A-Ritvik/Mission-Board/CAD/Case Parts(V2).step

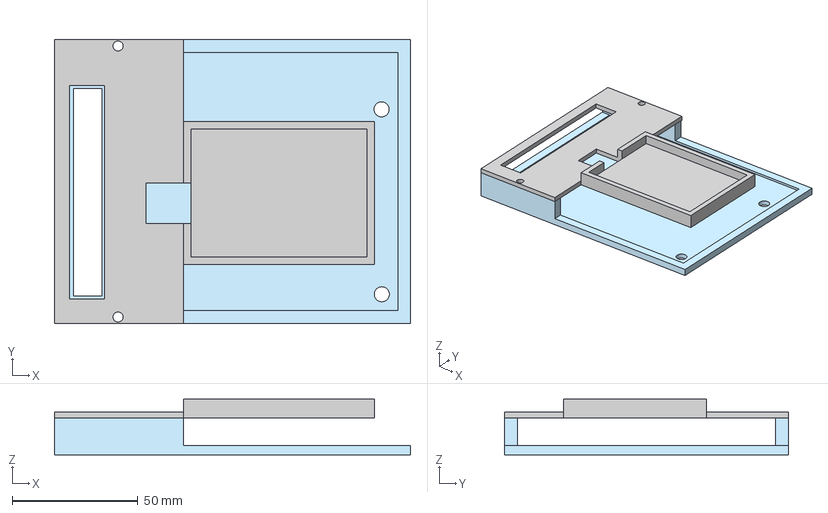
[picture p1: CAD file, 2026-08-01]
CAD/Case Parts(V2).step
141.7 x 112.9 x 22.2 mm
