A-Ritvik/Mission-Board/Production Files/Case Parts(V2) - Case-bottom.step

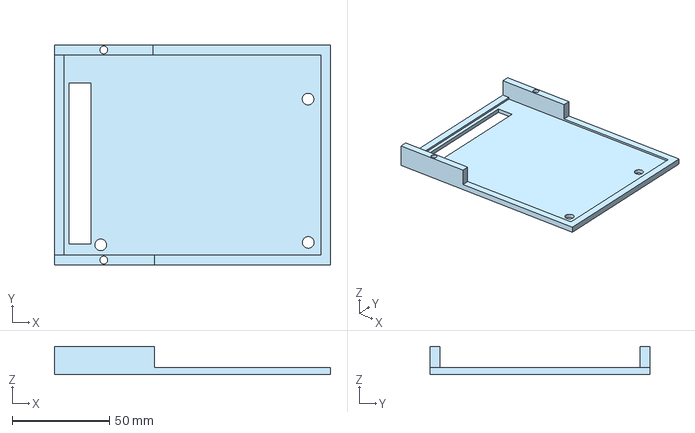
[picture p2: CAD file, 2026-08-01]
Production Files/Case Parts(V2) - Case-bottom.step
141.7 x 112.9 x 14.6 mm
