A-Ritvik/Mission-Board/Production Files/Case Parts(V2) - Case-top.step

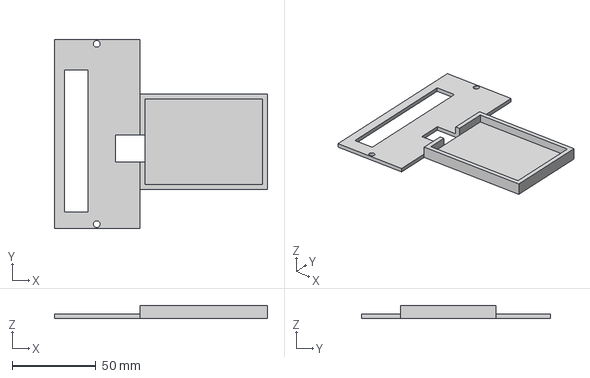
[picture p3: CAD file, 2026-08-01]
Production Files/Case Parts(V2) - Case-top.step
127.5 x 112.9 x 7.62 mm
