A-Ritvik/Mission-Board/PCB Design/missionBoard.kicad_pcb

## KiCad design PCB Design/missionBoard.kicad_pcb (2026-08-01)

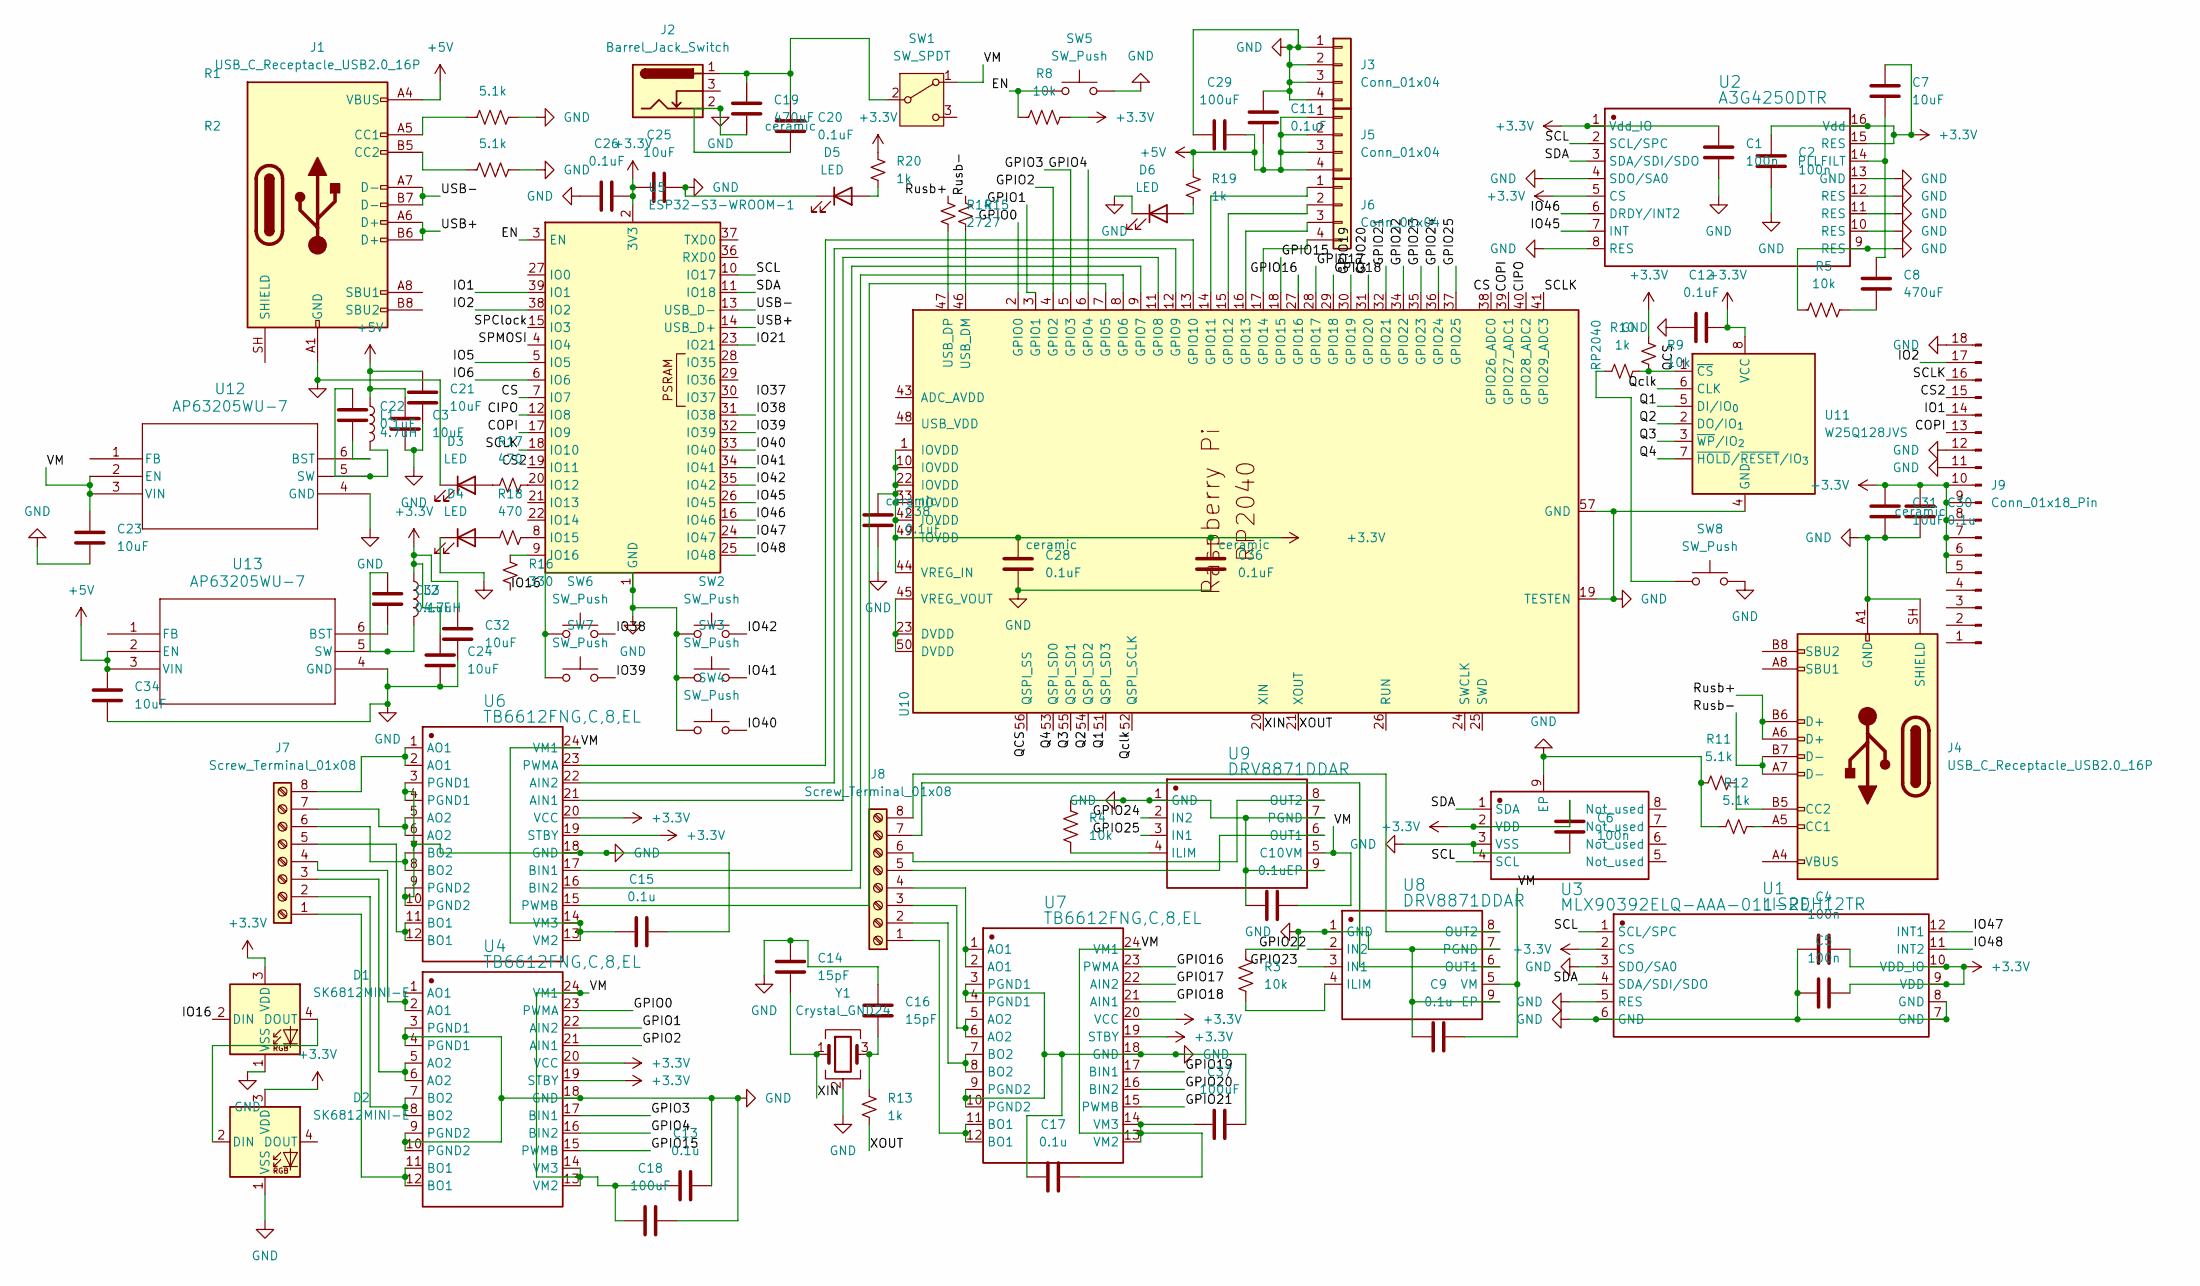
[picture p4: schematic missionBoard.kicad_sch]

Parts:
C1, C2, C4, C5, C6: 100n; C_0402_1005Metric
C3, C7, C21, C23, C24, C25, C31, C32, C34: 10uF; C_0402_1005Metric
C8, C19: 470uF; C_Elec_10x10.2
C9, C10, C13, C15, C17, C30: 0.1u; C_0402_1005Metric
C11, C12, C20, C22, C26, C28, C33, C36, C38: 0.1uF; C_0402_1005Metric
C14, C16: 15pF; C_0603_1608Metric
C18, C29, C37: 100uF; C_Elec_6.3x7.7
D1, D2: SK6812MINI-E; LED_SK6812MINI-E_3.2x2.8mm_P1.5mm_ReverseMount
D3, D4, D5, D6: LED; LED_0603_1608Metric
J1, J4: USB_C_Receptacle_USB2.0_16P; USB_C_Receptacle_HCTL_HC-TYPE-C-16P-01A
J2: Barrel_Jack_Switch; BarrelJack_Kycon_KLDX-0202-xC_Horizontal
J3, J5, J6: Conn_01x04; PinHeader_1x04_P2.54mm_Vertical
J7, J8: Screw_Terminal_01x08; TerminalBlock_Phoenix_MKDS-3-8-5.08_1x08_P5.08mm_Horizontal
J9: Conn_01x18_Pin; Hirose_FH12-18S-0.5SH_1x18-1MP_P0.50mm_Horizontal
L1, L2: 4.7uH; L_APV_ANR4030
R1, R2, R11, R12: 5.1k; R_0402_1005Metric
R3, R4, R5, R8, R9: 10k; R_0402_1005Metric
R10, R13: 1k; R_0402_1005Metric
R14, R15: 27; R_0402_1005Metric
R16: 330; R_0603_1608Metric
R17, R18: 470; R_0603_1608Metric
R19, R20: 1k; R_0603_1608Metric
SW1: SW_SPDT; SW_SPDT_Shouhan_MSK12C02
SW2, SW3, SW4, SW6, SW7: SW_Push; SW_SPST_SKQG_WithoutStem
SW5, SW8: SW_Push; SW_Push_SPST_NO_Alps_SKRK
U1: LIS2DH12TR; SENSOR_LIS2DH12; Manufacturer Part LIS2DH12TR
U2: A3G4250DTR; Manufacturer Part A3G4250DTR
U3: MLX90392ELQ-AAA-011-RE; UTDFN-8 2x2.5_MEL; Manufacturer Part MLX90392ELQ-AAA-011-RE
U4, U6, U7: TB6612FNG,C,8,EL; SOP65P760X160-24N; Manufacturer Part TB6612FNG,C,8,EL
U5: ESP32-S3-WROOM-1
U8, U9: DRV8871DDAR; VREG_LM5017MR_NOPB; Manufacturer Part DRV8871DDAR
U10: RP2040; RP2040-QFN-56
U11: W25Q128JVS; SOIC-8_5.3x5.3mm_P1.27mm
U12, U13: AP63205WU-7; SOIC_05WU-7_DIO
Y1: Crystal_GND24; Crystal_SMD_3225-4Pin_3.2x2.5mm

Connections:
+3.3V: C1.1, C2.1, C4.2, C5.2, C6.1, C7.1, C12.1, C24.1, C25.1, C26.2, C28.2, C30.1, C31.2, C32.1, C36.2, C38.2, D1.3 (VDD), D2.3 (VDD), J9.5, J9.6, J9.7, J9.8, J9.9, J9.10, L2.1, R8.2, R9.1, R20.1, U1.2 (CS), U1.9 (VDD), U1.10 (VDD_IO), U2.1 (Vdd_IO), U2.5 (CS), U2.15 (RES), U2.16 (Vdd), U3.2 (VDD), U4.19 (STBY), U4.20 (VCC), U5.2 (3V3), U6.19 (STBY), U6.20 (VCC), U7.19 (STBY), U7.20 (VCC), U10.1 (IOVDD), U10.10 (IOVDD), U10.22 (IOVDD), U10.33 (IOVDD), U10.42 (IOVDD), U10.44 (VREG_IN), U10.49 (IOVDD), U11.8 (VCC)
+5V: C3.1, C11.2, C21.1, C29.1, C34.1, J1.A4 (VBUS), J1.A9 (VBUS), J1.B4 (VBUS), J1.B9 (VBUS), J5.1, J5.2, J5.3, J5.4, L1.1, R19.1, U13.2 (EN), U13.3 (VIN)
/CIPO: U5.12 (IO8), U10.40 (GPIO28_ADC2)
/COPI: J9.13, U5.17 (IO9), U10.39 (GPIO27_ADC1)
/CS: U5.7 (IO7), U10.38 (GPIO26_ADC0)
/CS2: J9.15, U5.19 (IO11)
/EN: R8.1, SW5.1, U5.3 (EN)
/GPIO0: U4.23 (PWMA), U10.2 (GPIO0)
/GPIO1: U4.22 (AIN2), U10.3 (GPIO1)
/GPIO2: U4.21 (AIN1), U10.4 (GPIO2)
/GPIO3: U4.17 (BIN1), U10.5 (GPIO3)
/GPIO4: U4.16 (BIN2), U10.6 (GPIO4)
/GPIO15: U4.15 (PWMB), U10.18 (GPIO15)
/GPIO16: U7.23 (PWMA), U10.27 (GPIO16)
/GPIO17: U7.22 (AIN2), U10.28 (GPIO17)
/GPIO18: U7.21 (AIN1), U10.29 (GPIO18)
/GPIO19: U7.17 (BIN1), U10.30 (GPIO19)
/GPIO20: U7.16 (BIN2), U10.31 (GPIO20)
/GPIO21: U7.15 (PWMB), U10.32 (GPIO21)
/GPIO22: U8.2 (IN2), U10.34 (GPIO22)
/GPIO23: U8.3 (IN1), U10.35 (GPIO23)
/GPIO24: U9.2 (IN2), U10.36 (GPIO24)
/GPIO25: U9.3 (IN1), U10.37 (GPIO25)
/IO1: J9.14, U5.39 (IO1)
/IO2: J9.17, U5.38 (IO2)
/IO5: U5.5 (IO5)
/IO6: U5.6 (IO6)
/IO16: D1.2 (DIN), R16.2
/IO21: U5.23 (IO21)
/IO38: SW6.2, U5.31 (IO38)
/IO39: SW7.2, U5.32 (IO39)
/IO40: SW4.2, U5.33 (IO40)
/IO41: SW3.2, U5.34 (IO41)
/IO42: SW2.2, U5.35 (IO42)
/IO45: U2.7 (INT), U5.26 (IO45)
/IO46: U2.6 (DRDY/INT2), U5.16 (IO46)
/IO47: U1.12 (INT1), U5.24 (IO47)
/IO48: U1.11 (INT2), U5.25 (IO48)
/Q1: U10.51 (QSPI_SD3), U11.5 (DI/IO_{0})
/Q2: U10.54 (QSPI_SD2), U11.2 (DO/IO_{1})
/Q3: U10.55 (QSPI_SD1), U11.3 (~WP/IO_{2})
/Q4: U10.53 (QSPI_SD0), U11.7 (~HOLD/~RESET/IO_{3})
/QCS: R9.2, R10.2, U10.56 (QSPI_SS), U11.1 (~CS)
/Qclk: U10.52 (QSPI_SCLK), U11.6 (CLK)
/Rusb+: J4.A6 (D+), J4.B6 (D+), R14.1
/Rusb-: J4.A7 (D-), J4.B7 (D-), R15.1
/SCL: U1.1 (SCL/SPC), U2.2 (SCL/SPC), U3.4 (SCL), U5.10 (IO17)
/SCLK: J9.16, U5.18 (IO10), U10.41 (GPIO29_ADC3)
/SDA: U1.4 (SDA/SDI/SDO), U2.3 (SDA/SDI/SDO), U3.1 (SDA), U5.11 (IO18)
/SPClock: U5.15 (IO3)
/SPMOSI: U5.4 (IO4)
/USB+: J1.A6 (D+), J1.B6 (D+), U5.14 (USB_D+)
/USB-: J1.A7 (D-), J1.B7 (D-), U5.13 (USB_D-)
/VM: C9.1, C10.1, C13.2, C15.2, C17.1, C18.1, C23.1, C37.1, SW1.1 (A), U4.13 (VM2), U4.14 (VM3), U4.24 (VM1), U6.13 (VM2), U6.14 (VM3), U6.24 (VM1), U7.13 (VM2), U7.14 (VM3), U7.24 (VM1), U8.5 (VM), U9.5 (VM), U12.2 (EN), U12.3 (VIN)
/XIN: C14.2, U10.20 (XIN), Y1.1
/XOUT: R13.2, U10.21 (XOUT)
GND: C1.2, C2.2, C3.2, C4.1, C5.1, C6.2, C9.2, C10.2, C11.1, C12.2, C13.1, C14.1, C15.1, C16.1, C17.2, C18.2, C19.2, C20.1, C21.2, C23.2, C24.2, C25.2, C26.1, C28.1, C29.2, C30.2, C31.1, C32.2, C34.2, C36.1, C37.2, C38.1, D1.1 (VSS), D2.1 (VSS), D3.1 (K), D4.1 (K), D5.1 (K), D6.1 (K), J1.A1 (GND), J1.A12 (GND), J1.B1 (GND), J1.B12 (GND), J2.2, J3.1, J3.2, J3.3, J3.4, J4.A1 (GND), J4.A12 (GND), J4.B1 (GND), J4.B12 (GND), J4.SH (SHIELD), J9.11, J9.12, J9.18, R1.2, R2.2, R3.2, R4.2, R5.1, R11.1, R12.1, SW2.1, SW3.1, SW4.1, SW5.2, SW6.1, SW7.1, SW8.2, U1.3 (SDO/SA0), U1.5 (RES), U1.6 (GND), U1.7 (GND), U1.8 (GND), U2.4 (SDO/SA0), U2.8 (RES), U2.9 (RES), U2.10 (RES), U2.11 (RES), U2.12 (RES), U2.13 (GND), U3.3 (VSS), U3.9 (EP), U4.3 (PGND1), U4.4 (PGND1), U4.9 (PGND2), U4.10 (PGND2), U4.18 (GND), U5.1 (GND), U5.40 (GND), U5.41 (GND), U6.3 (PGND1), U6.4 (PGND1), U6.9 (PGND2), U6.10 (PGND2), U6.18 (GND), U7.3 (PGND1), U7.4 (PGND1), U7.9 (PGND2), U7.10 (PGND2), U7.18 (GND), U8.1 (GND), U8.7 (PGND), U8.9 (EP), U9.1 (GND), U9.7 (PGND), U9.9 (EP), U10.19 (TESTEN), U10.57 (GND), U11.4 (GND), U12.4 (GND), U13.4 (GND), Y1.2 (G), Y1.4 (G)
unnamed: C8.2, R5.2
unnamed: C16.2, R13.1, Y1.3
unnamed: D1.4 (DOUT), D2.2 (DIN)
unnamed: D3.2 (A), R17.1
unnamed: D4.2 (A), R18.1
unnamed: D5.2 (A), R20.2
unnamed: D6.2 (A), R19.2
unnamed: J1.A5 (CC1), R1.1
unnamed: J1.B5 (CC2), R2.1
unnamed: J4.A5 (CC1), R12.2
unnamed: J4.B5 (CC2), R11.2
unnamed: J4.A4 (VBUS), J4.A9 (VBUS), J4.B4 (VBUS), J4.B9 (VBUS)
unnamed: J6.1, U10.14 (GPIO11)
unnamed: J6.2, U10.15 (GPIO12)
unnamed: J6.3, U10.16 (GPIO13)
unnamed: J6.4, U10.17 (GPIO14)
unnamed: J7.1, U4.11 (BO1), U4.12 (BO1)
unnamed: J7.2, U4.7 (BO2), U4.8 (BO2)
unnamed: J7.3, U4.5 (AO2), U4.6 (AO2)
unnamed: J7.4, U4.1 (AO1), U4.2 (AO1)
unnamed: J7.5, U6.11 (BO1), U6.12 (BO1)
unnamed: J7.6, U6.7 (BO2), U6.8 (BO2)
unnamed: J7.7, U6.5 (AO2), U6.6 (AO2)
unnamed: J7.8, U6.1 (AO1), U6.2 (AO1)
unnamed: J8.1, U7.11 (BO1), U7.12 (BO1)
unnamed: J8.2, U7.7 (BO2), U7.8 (BO2)
unnamed: J8.3, U7.5 (AO2), U7.6 (AO2)
unnamed: J8.4, U7.1 (AO1), U7.2 (AO1)
unnamed: J8.5, U9.6 (OUT1)
unnamed: J8.6, U9.8 (OUT2)
unnamed: J8.7, U8.6 (OUT1)
unnamed: J8.8, U8.8 (OUT2)
unnamed: R10.1, SW8.1
unnamed: C19.1, C20.2, J2.1, SW1.2 (B)
unnamed: C7.2, C8.1, U2.14 (PLLFILT)
unnamed: R17.2, U5.20 (IO12)
unnamed: R18.2, U5.8 (IO15)
unnamed: R16.1, U5.9 (IO16)
unnamed: R3.1, U8.4 (ILIM)
unnamed: R4.1, U9.4 (ILIM)
unnamed: U6.15 (PWMB), U10.7 (GPIO5)
unnamed: U6.16 (BIN2), U10.8 (GPIO6)
unnamed: U6.17 (BIN1), U10.9 (GPIO7)
unnamed: U6.21 (AIN1), U10.11 (GPIO8)
unnamed: U6.22 (AIN2), U10.12 (GPIO9)
unnamed: U6.23 (PWMA), U10.13 (GPIO10)
unnamed: R15.2, U10.46 (USB_DM)
unnamed: R14.2, U10.47 (USB_DP)
unnamed: U10.23 (DVDD), U10.45 (VREG_VOUT), U10.50 (DVDD)
unnamed: C22.2, U12.6 (BST)
unnamed: C22.1, L1.2, U12.5 (SW)
unnamed: C33.2, U13.6 (BST)
unnamed: C33.1, L2.2, U13.5 (SW)

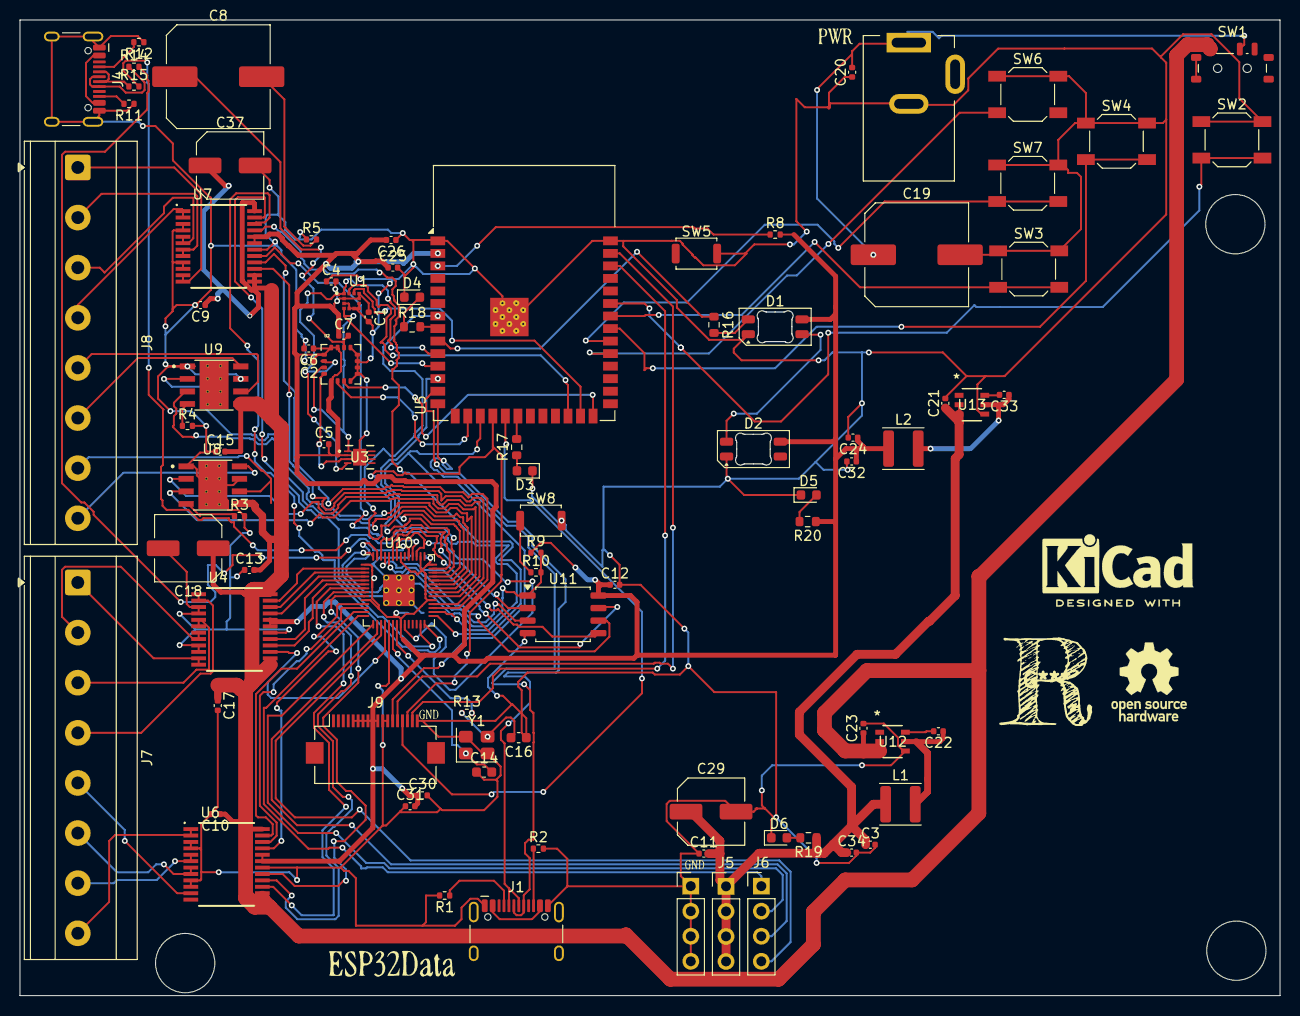
[picture p5: board missionBoard.kicad_pcb from above]

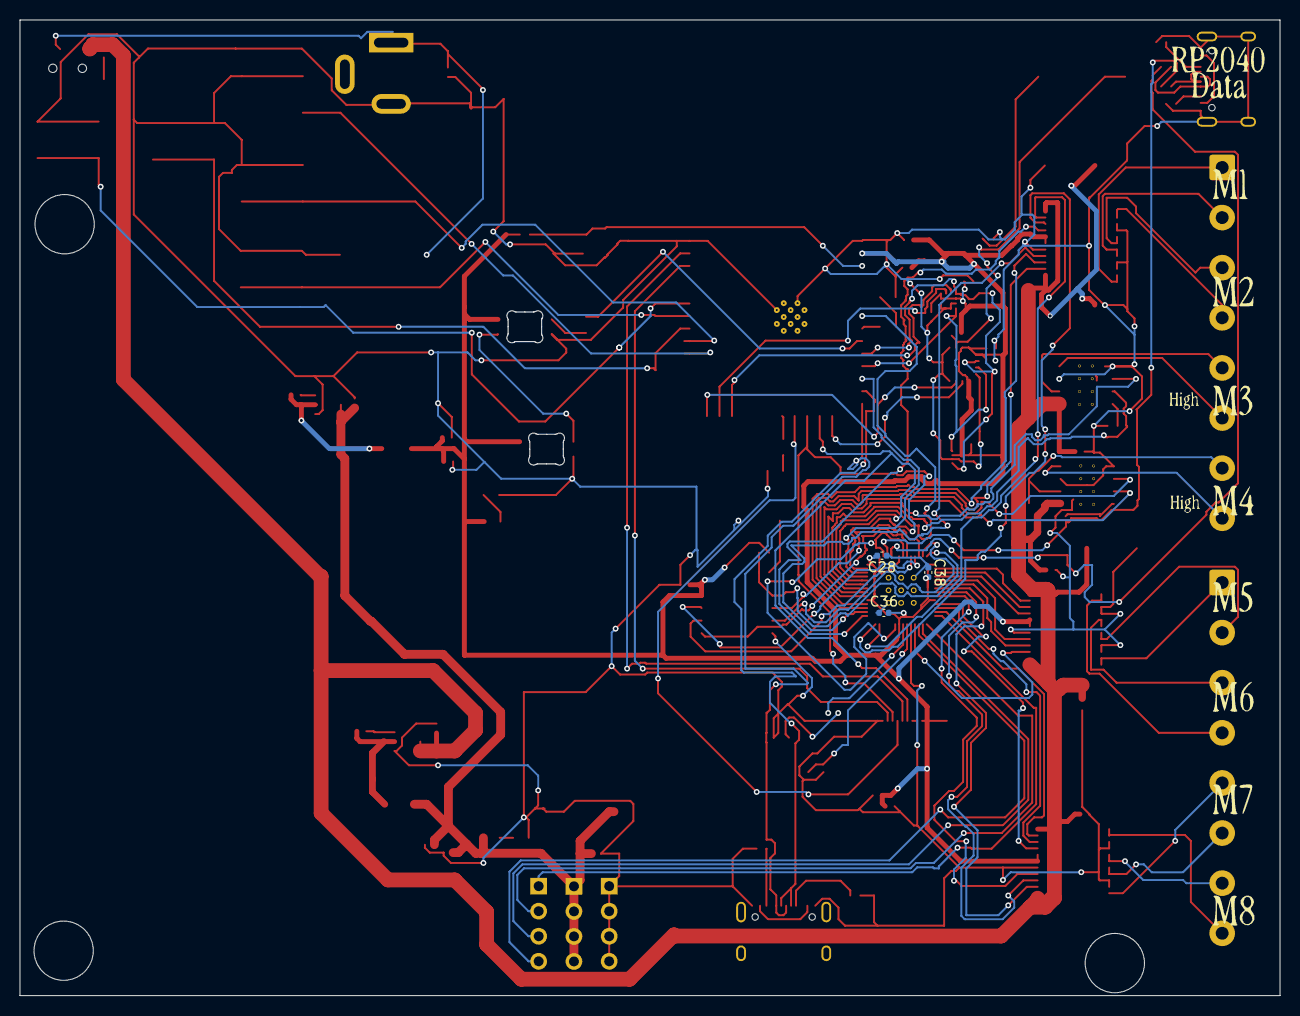
[picture p6: board missionBoard.kicad_pcb from below]

Board: 2 copper layers, 127.7 x 98.9 mm, 93 parts (3 on the bottom side), 105 nets.
