A-Ritvik/Mission-Board/(commit log)

2026-08-01 Create README.md for mission board project
    Added detailed information about the mission board, including features, images, case design, schematic, and bill of materials.
2026-08-01 Moved BOM File
    [MissionBoardBOM.csv]
2026-08-06 Added Basic Code
    Added basic scripts for the esp32 and rp2040 processors to test functionality (will build on it later)
